nrwiersma/hardware-components/models/C_Pol_Elec_8x10.step

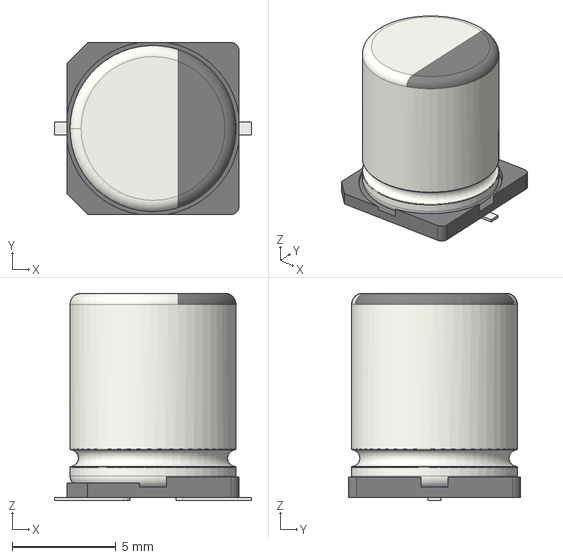
[picture p1: CAD file, 2026-09-28]
models/C_Pol_Elec_8x10.step
9.50 x 8.30 x 10.0 mm
