nrwiersma/hardware-components/models/Conn_Weidmuller_8000078321.step

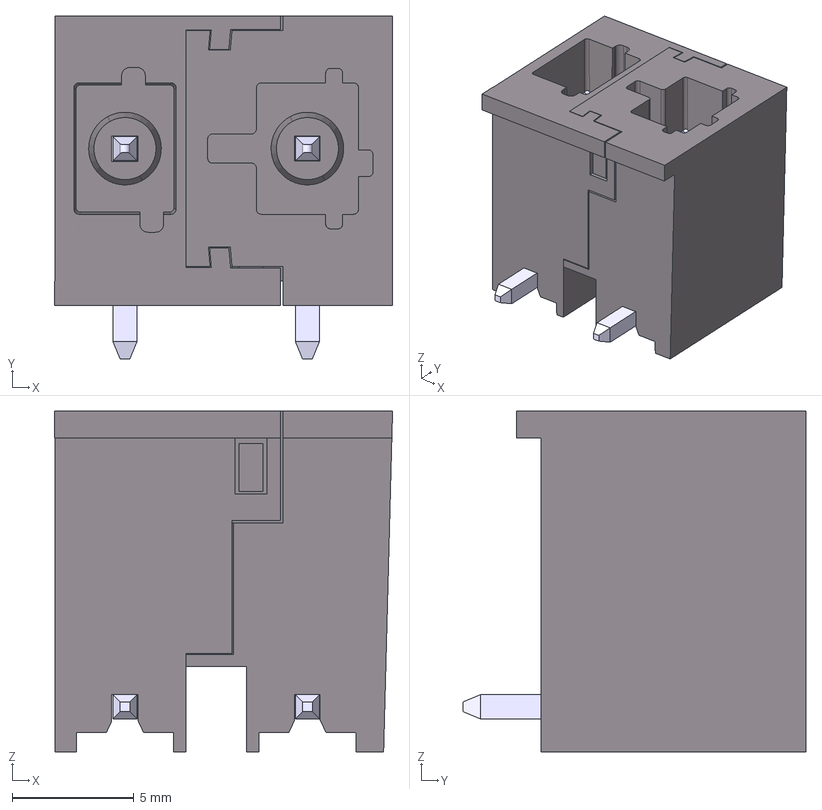
[picture p2: CAD file, 2026-09-28]
models/Conn_Weidmuller_8000078321.step
13.9 x 14.1 x 14.0 mm
X-axis x 3
XY-plane x 3
