nrwiersma/hardware-components/models/Conn_RCA_SameSky_RCJ-041.step

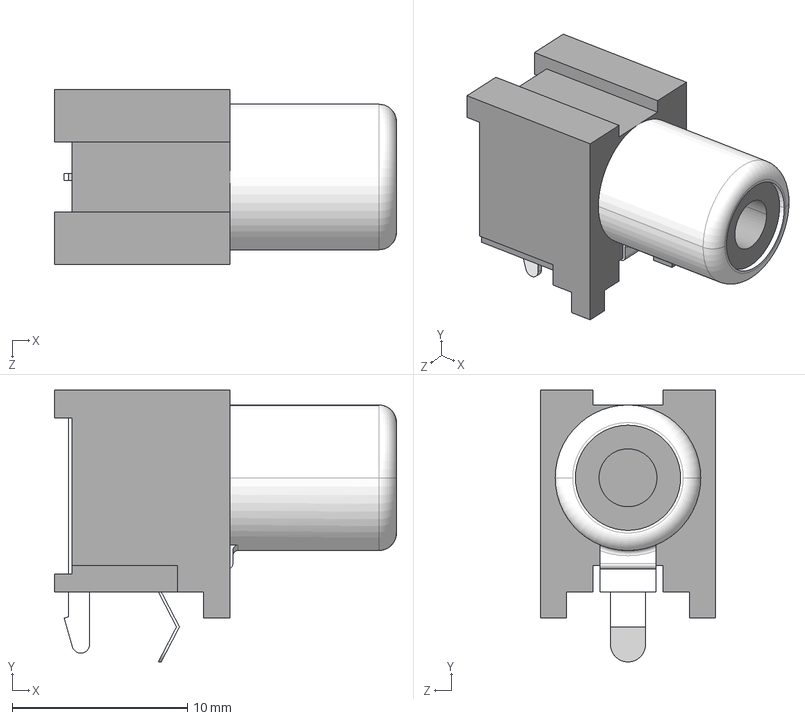
[picture p3: CAD file, 2026-09-28]
models/Conn_RCA_SameSky_RCJ-041.step
19.5 x 15.5 x 10.0 mm
