nrwiersma/hardware-components/models/HTSSOP-28.step

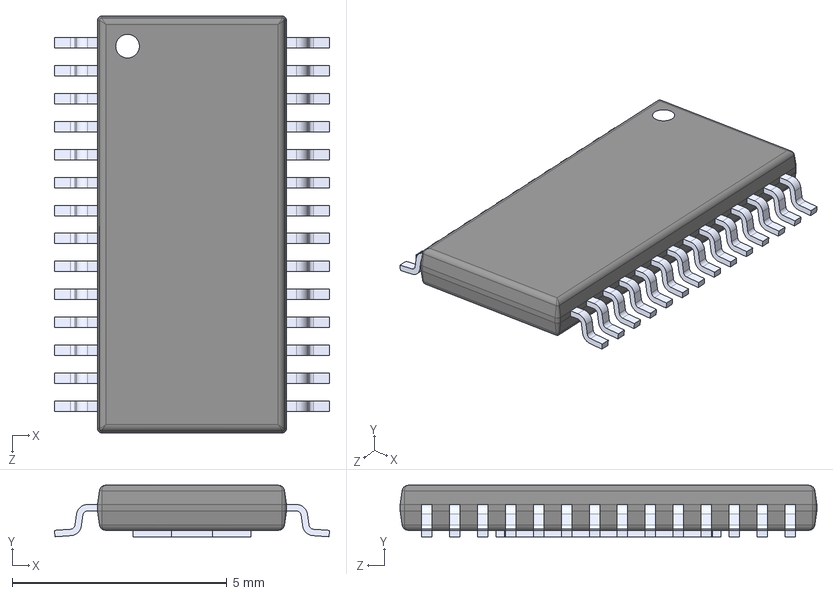
[picture p4: CAD file, 2026-09-28]
models/HTSSOP-28.step
6.40 x 1.20 x 9.70 mm
