nrwiersma/hardware-components/models/L_Sunltech_SLD10D40S100MTT.step

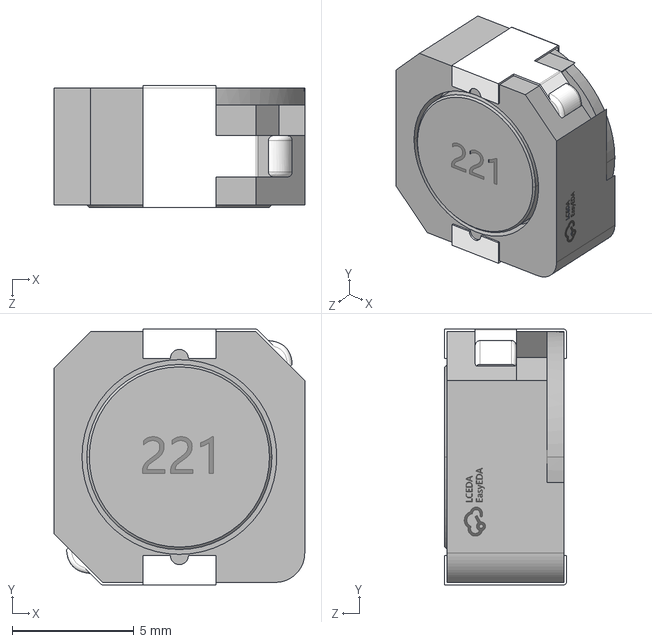
[picture p5: CAD file, 2026-09-28]
models/L_Sunltech_SLD10D40S100MTT.step
10.3 x 10.5 x 5.00 mm
