nrwiersma/hardware-components/models/Conn_BarrelJack_KHE_DC-044A-20A.step

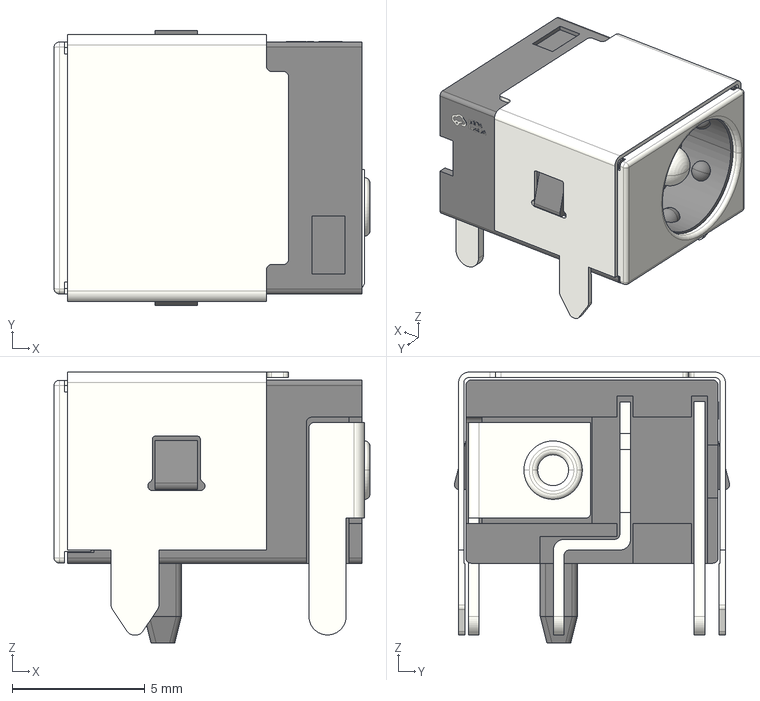
[picture p6: CAD file, 2026-09-28]
models/Conn_BarrelJack_KHE_DC-044A-20A.step
11.9 x 10.4 x 10.2 mm
