nrwiersma/hardware-components/models/PowMan_TPS2121RUXR.step

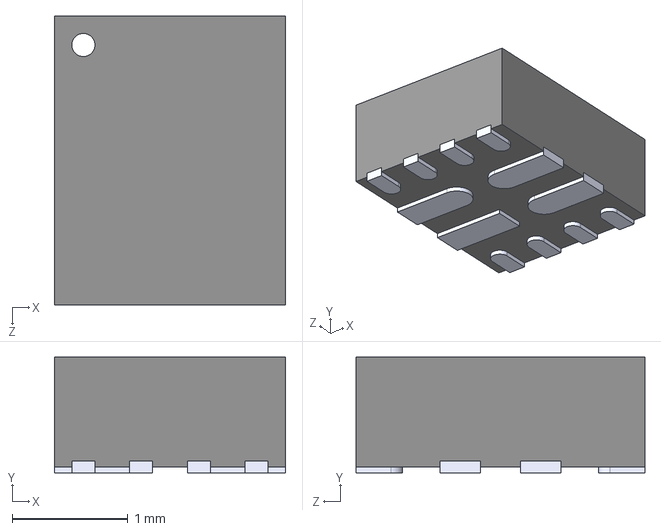
[picture p7: CAD file, 2026-09-28]
models/PowMan_TPS2121RUXR.step
2.00 x 1.00 x 2.50 mm
