nrwiersma/hardware-components/models/SOIC-8_5.3x5.3mm_P1.27mm.step

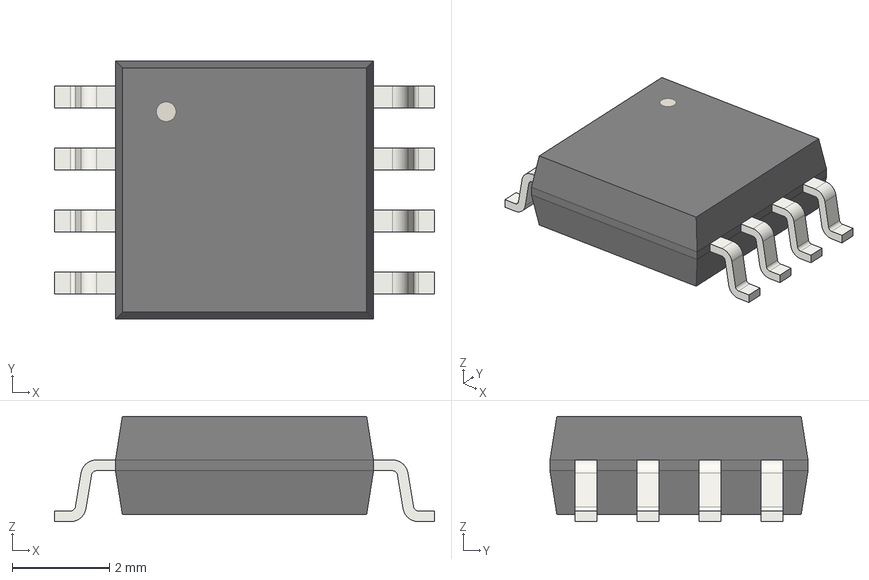
[picture p8: CAD file, 2026-09-28]
models/SOIC-8_5.3x5.3mm_P1.27mm.step
7.80 x 5.30 x 2.16 mm
