nrwiersma/hardware-components/models/BH1750FVI-TR.step

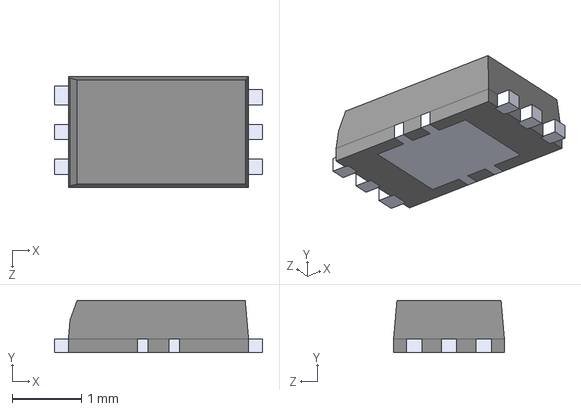
[picture p9: CAD file, 2026-08-22]
models/BH1750FVI-TR.step
3.00 x 0.75 x 1.60 mm
