nrwiersma/hardware-components/models/Sensirion_DFN-4.step

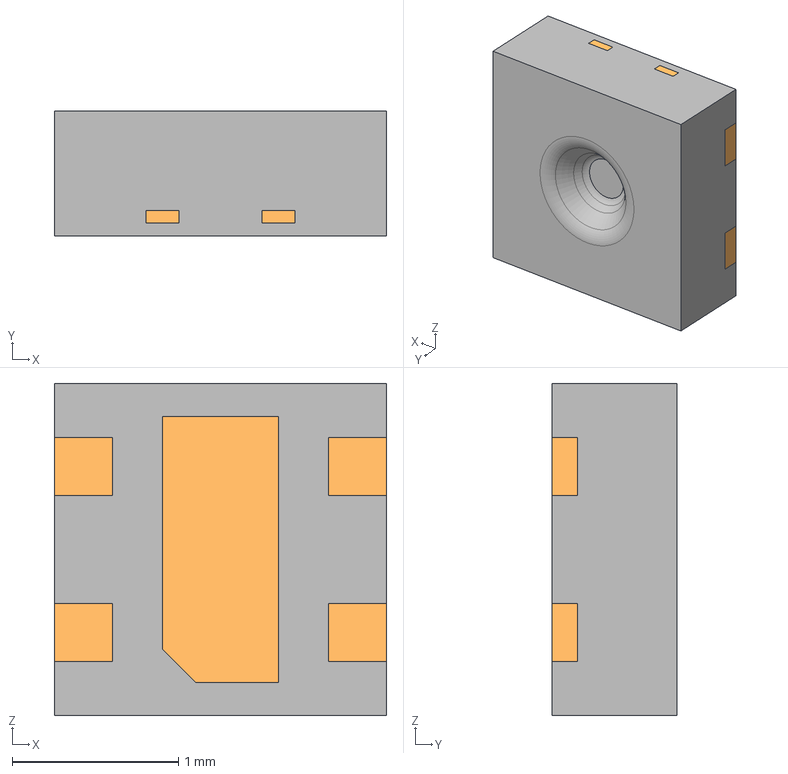
[picture p10: CAD file, 2026-08-22]
models/Sensirion_DFN-4.step
2.00 x 0.75 x 2.00 mm
