nrwiersma/hardware-components/models/LED_WS2812C-2020.step

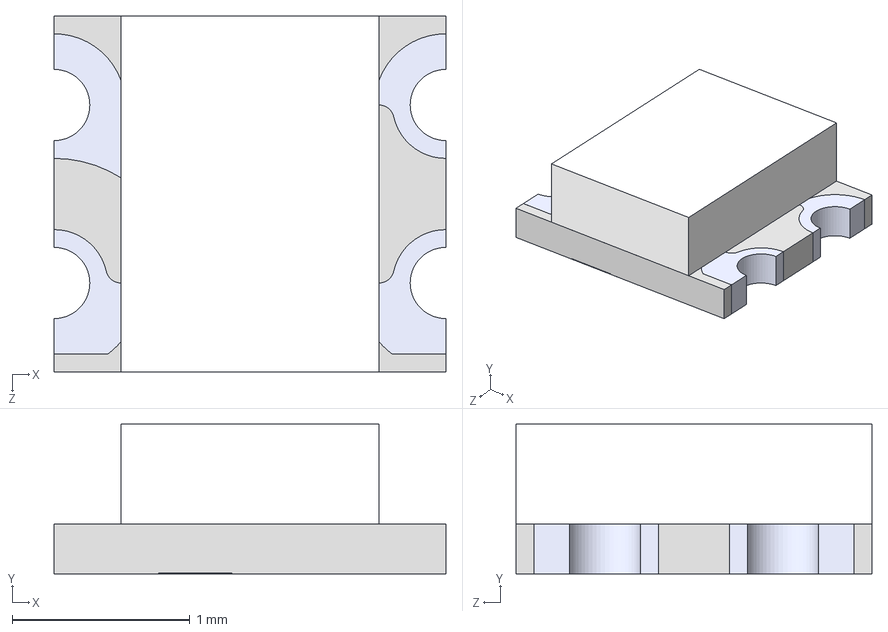
[picture p11: CAD file, 2026-08-22]
models/LED_WS2812C-2020.step
2.20 x 0.84 x 2.00 mm
