nrwiersma/hardware-components/models/HLK-LD2450.step

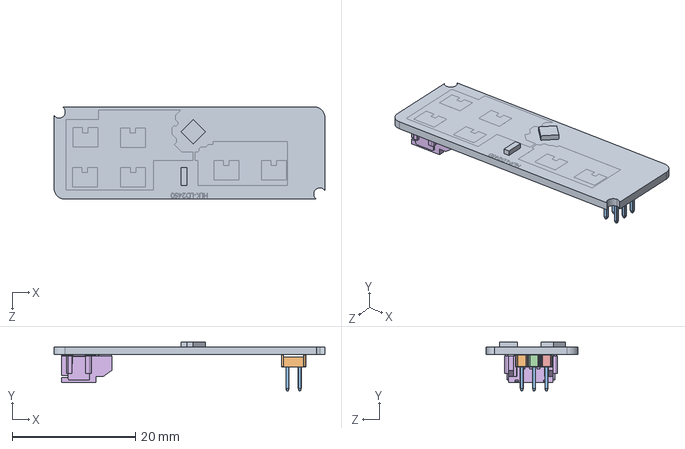
[picture p12: CAD file, 2026-08-22]
models/HLK-LD2450.step
44.0 x 7.95 x 15.0 mm
