nrwiersma/hardware-components/models/PowMan_TPS2116DRLR.step

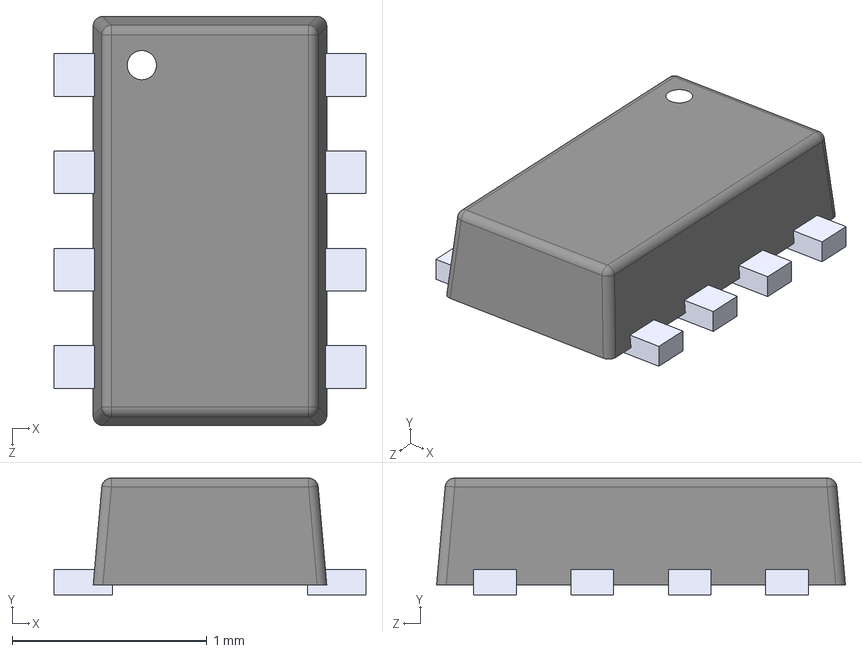
[picture p13: CAD file, 2026-08-22]
models/PowMan_TPS2116DRLR.step
1.60 x 0.6 x 2.10 mm
