nrwiersma/hardware-components/models/Conn_PinSocket_2x04_P2mm_Vertical_SMD.step

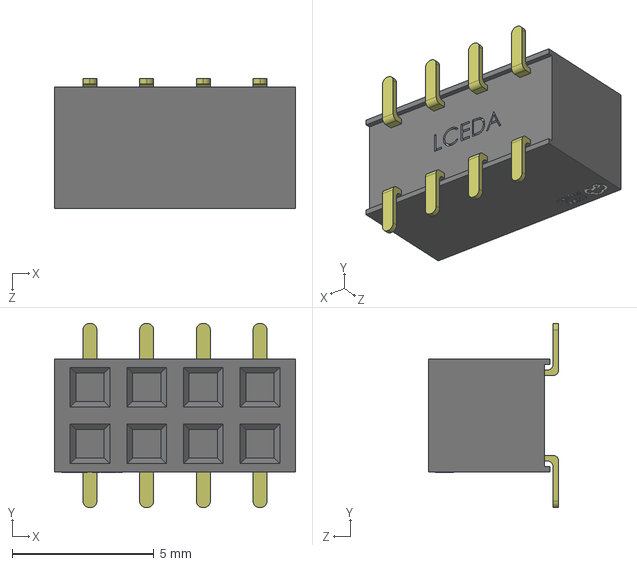
[picture p14: CAD file, 2026-08-22]
models/Conn_PinSocket_2x04_P2mm_Vertical_SMD.step
8.50 x 6.50 x 4.60 mm
