nrwiersma/hardware-components/models/D_SOD-323.step

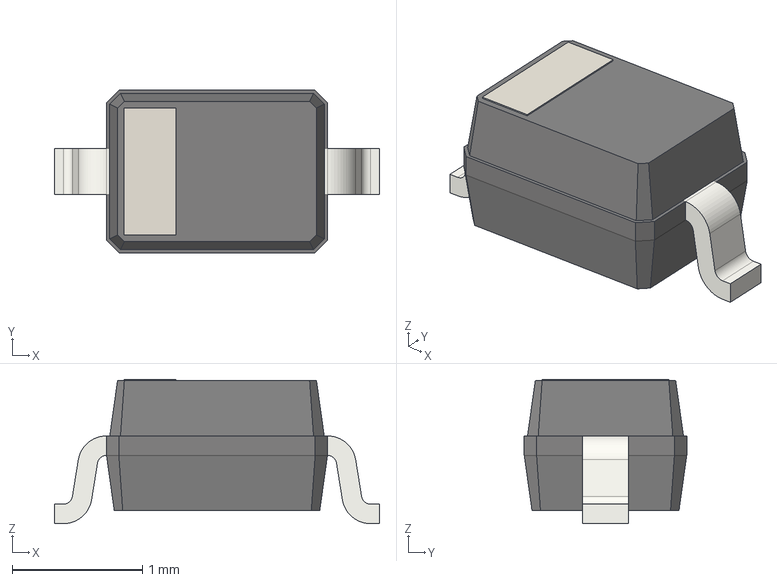
[picture p15: CAD file, 2026-08-22]
models/D_SOD-323.step
2.50 x 1.25 x 1.11 mm
