nrwiersma/hardware-components/models/Conn_PinSocket_2x04_P2.00mm_Vertical.step

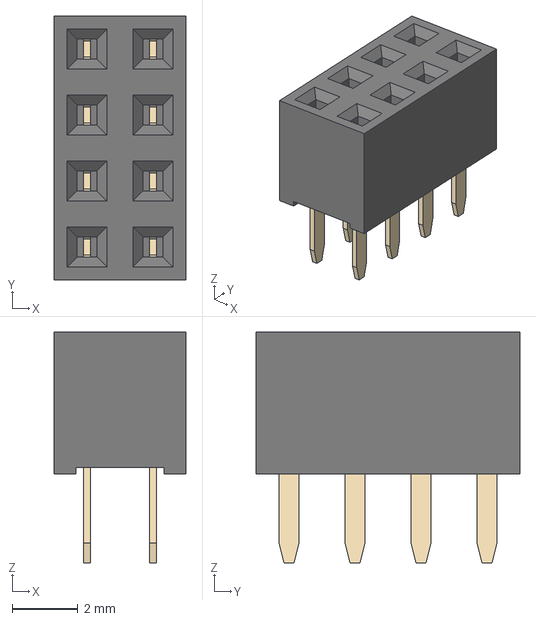
[picture p16: CAD file, 2026-08-22]
models/Conn_PinSocket_2x04_P2.00mm_Vertical.step
4.00 x 8.00 x 7.00 mm
