nrwiersma/hardware-components/models/C_0402_1005Metric.step

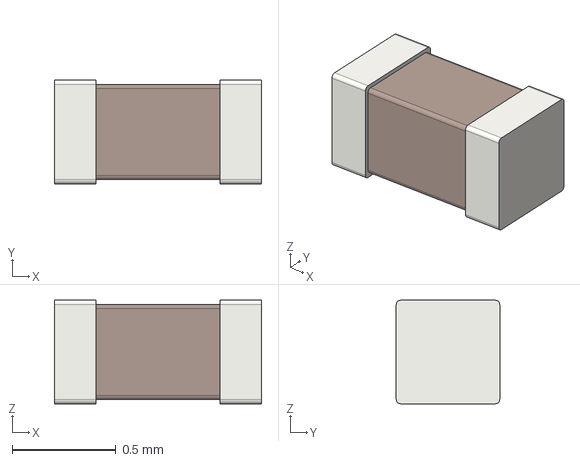
[picture p17: CAD file, 2025-12-20]
models/C_0402_1005Metric.step
1.00 x 0.5 x 0.5 mm
