nrwiersma/hardware-components/models/R_0402_1005Metric.step

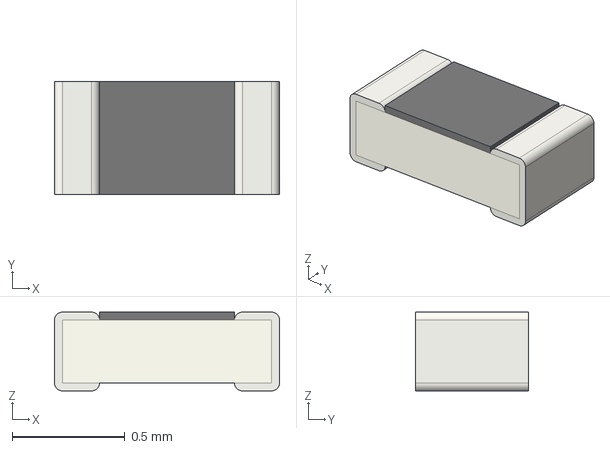
[picture p18: CAD file, 2025-12-20]
models/R_0402_1005Metric.step
1.00 x 0.5 x 0.35 mm
