nrwiersma/hardware-components/models/L_Chilisin_BMRx00060630.step

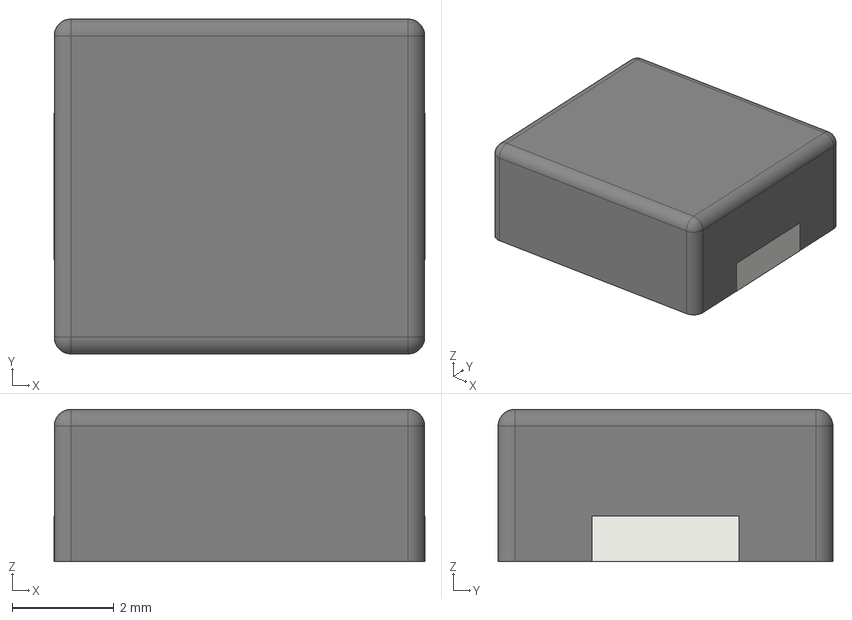
[picture p19: CAD file, 2025-12-20]
models/L_Chilisin_BMRx00060630.step
7.31 x 6.60 x 3.00 mm
b9f41f3a-8551-11ed-b402-00155d22e2d7_part
b9f42070-8551-11ed-b402-00155d22e2d7_part
b9f420f2-8551-11ed-b402-00155d22e2d7_part
