nrwiersma/hardware-components/models/TPD4EUSB30_USON-10.step

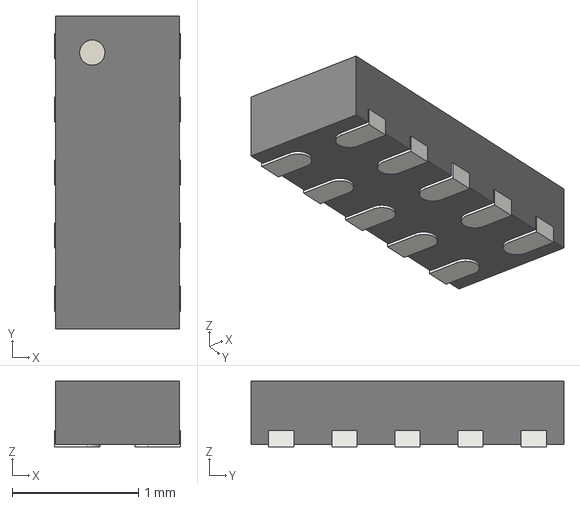
[picture p20: CAD file, 2025-12-20]
models/TPD4EUSB30_USON-10.step
1.00 x 2.48 x 0.52 mm
