nrwiersma/hardware-components/models/LED_0603_1608Metric.step

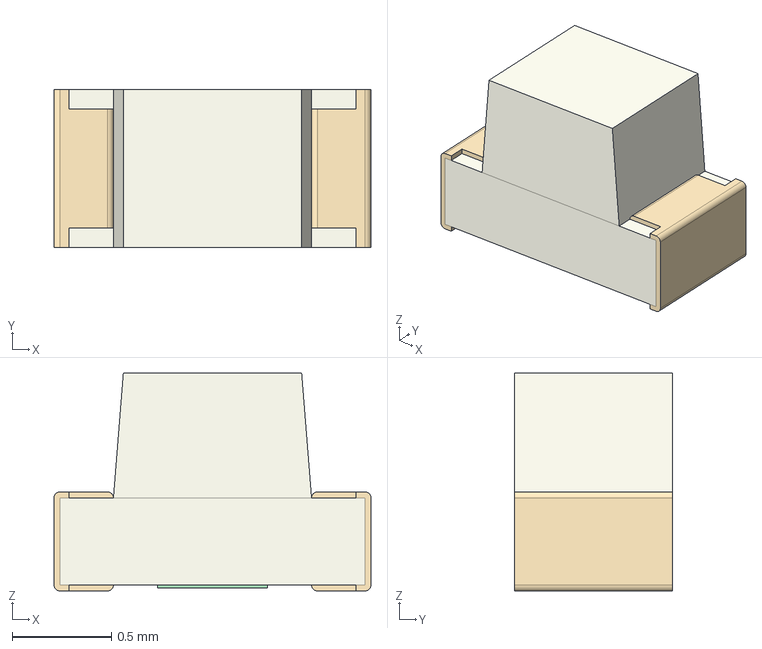
[picture p21: CAD file, 2025-12-20]
models/LED_0603_1608Metric.step
1.60 x 0.8 x 1.10 mm
