nrwiersma/hardware-components/models/Conn_JST_PH_S4B-PH-K_1x04_P2.00mm_Horizontal.step

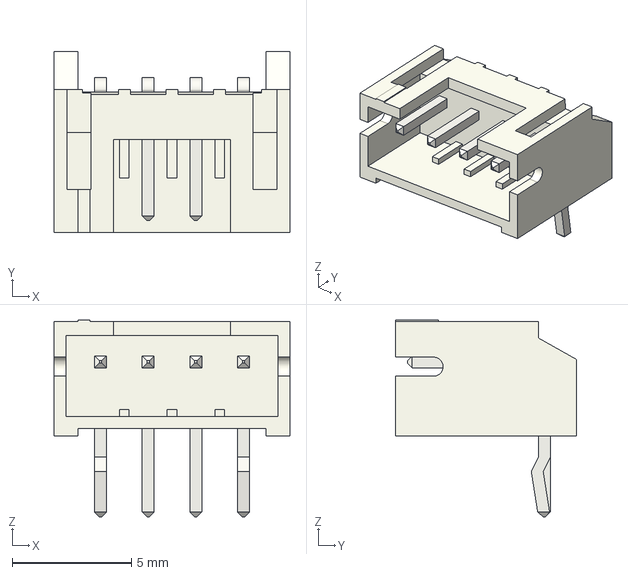
[picture p22: CAD file, 2025-12-20]
models/Conn_JST_PH_S4B-PH-K_1x04_P2.00mm_Horizontal.step
9.90 x 7.60 x 8.25 mm
