nrwiersma/hardware-components/models/SSR_SUPSiC_GAQY212GSX.step

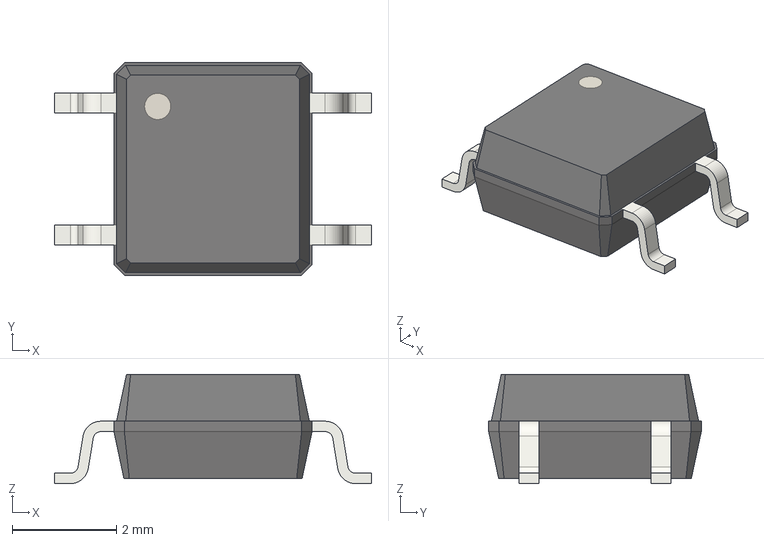
[picture p23: CAD file, 2025-12-20]
models/SSR_SUPSiC_GAQY212GSX.step
6.10 x 4.09 x 2.10 mm
