nrwiersma/hardware-components/models/QFN-32-1EP.step

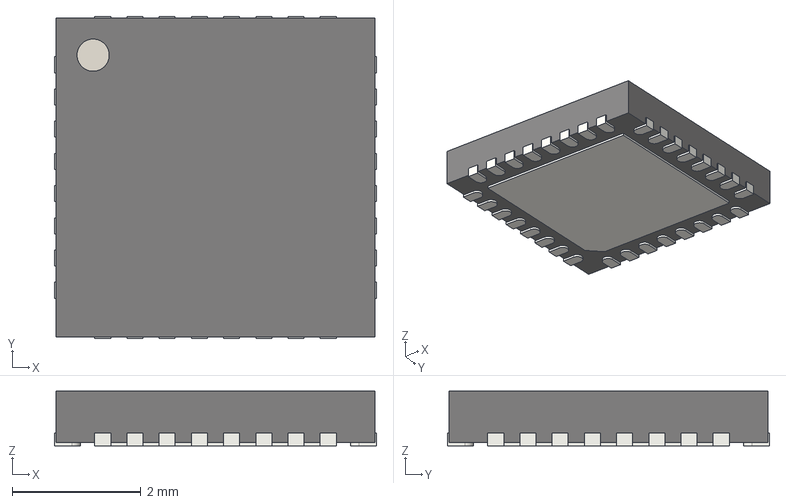
[picture p24: CAD file, 2025-12-20]
models/QFN-32-1EP.step
5.00 x 5.00 x 0.85 mm
