nrwiersma/hardware-components/models/Conn_JST_PH_S3B-PH-K_1x03_P2.00mm_Horizontal.step

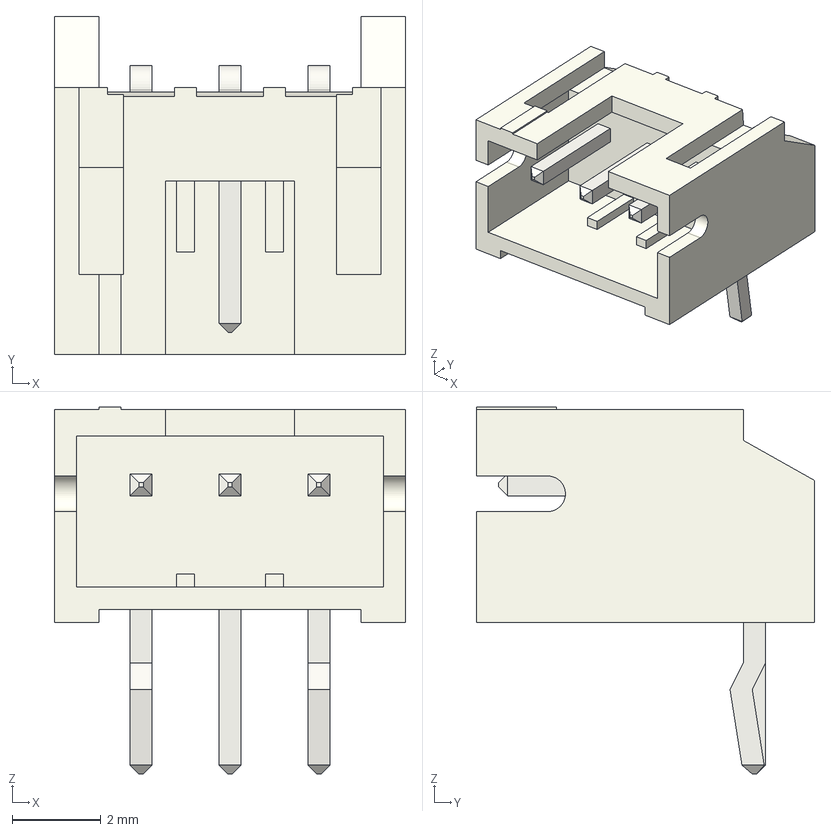
[picture p25: CAD file, 2025-12-20]
models/Conn_JST_PH_S3B-PH-K_1x03_P2.00mm_Horizontal.step
7.90 x 7.60 x 8.25 mm
