nrwiersma/hardware-components/models/C_0201_0603Metric.step

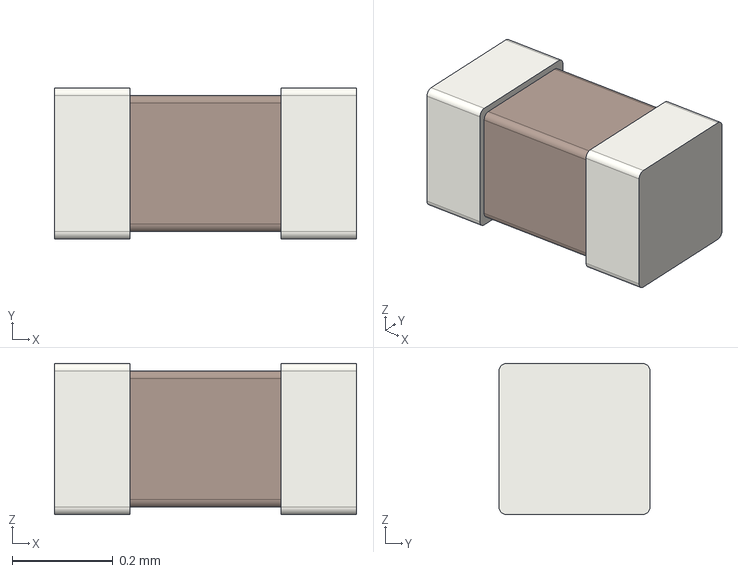
[picture p26: CAD file, 2025-12-20]
models/C_0201_0603Metric.step
0.6 x 0.3 x 0.3 mm
