nrwiersma/hardware-components/models/SMD-FERRITE-BEAD-30R-3A_0805_.step

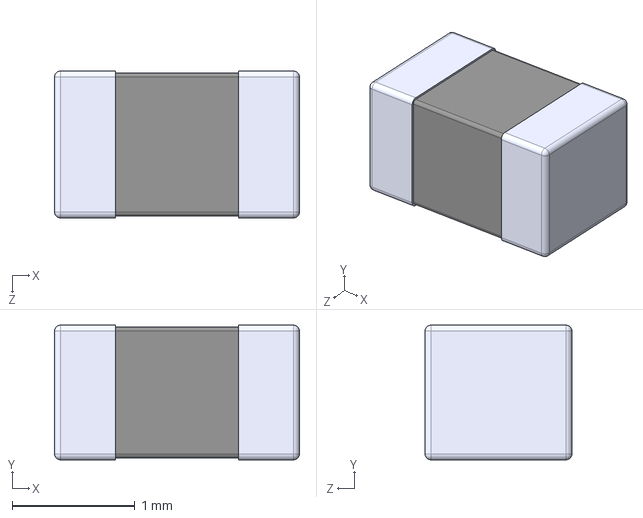
[picture p27: CAD file, 2025-12-20]
models/SMD-FERRITE-BEAD-30R-3A_0805_.step
2.00 x 1.10 x 1.20 mm
