nrwiersma/hardware-components/models/Conn_PinHeader_2x05_P2.54mm_Vertical.step

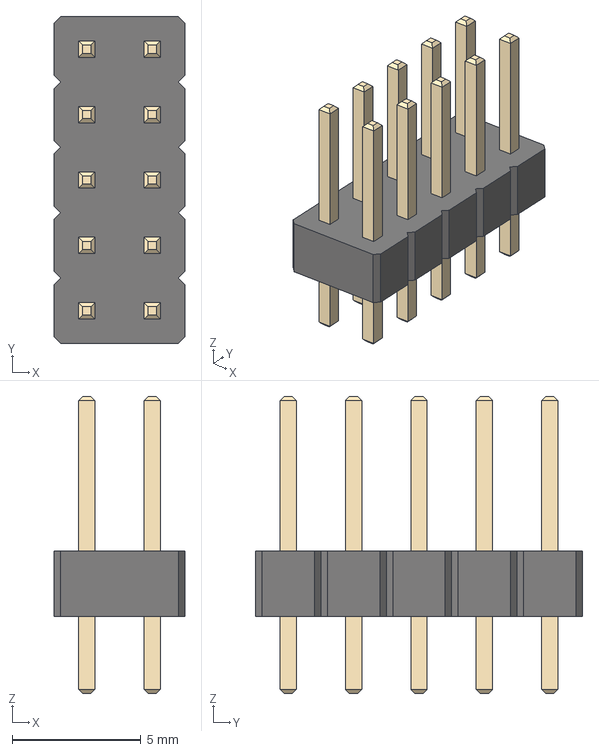
[picture p28: CAD file, 2025-12-20]
models/Conn_PinHeader_2x05_P2.54mm_Vertical.step
5.08 x 12.7 x 11.5 mm
