nrwiersma/hardware-components/models/D_0402_1005Metric.STEP

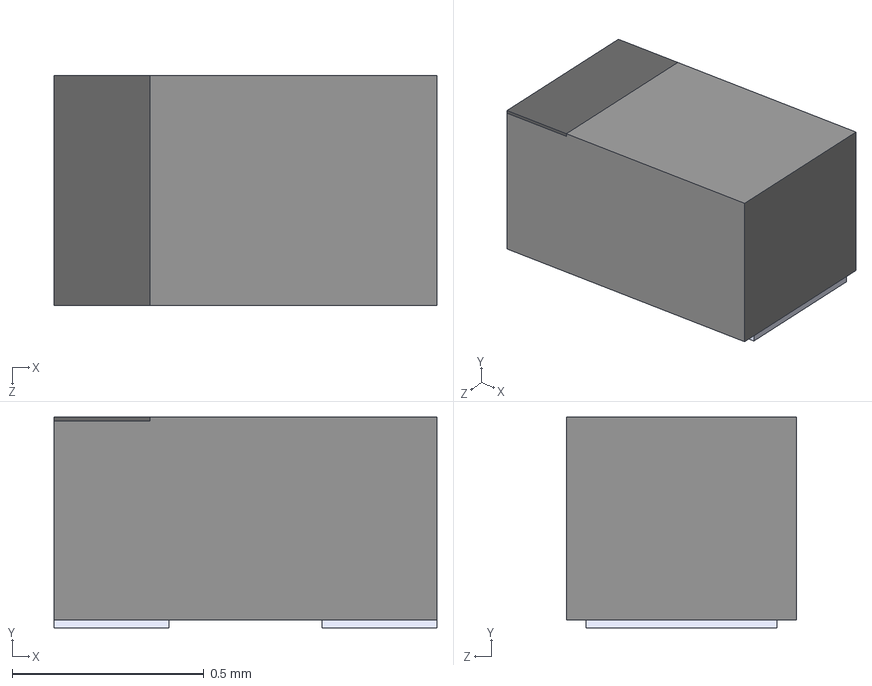
[picture p29: CAD file, 2025-12-20]
models/D_0402_1005Metric.STEP
1.00 x 0.55 x 0.6 mm
