nrwiersma/hardware-components/models/SOT-89-3.step

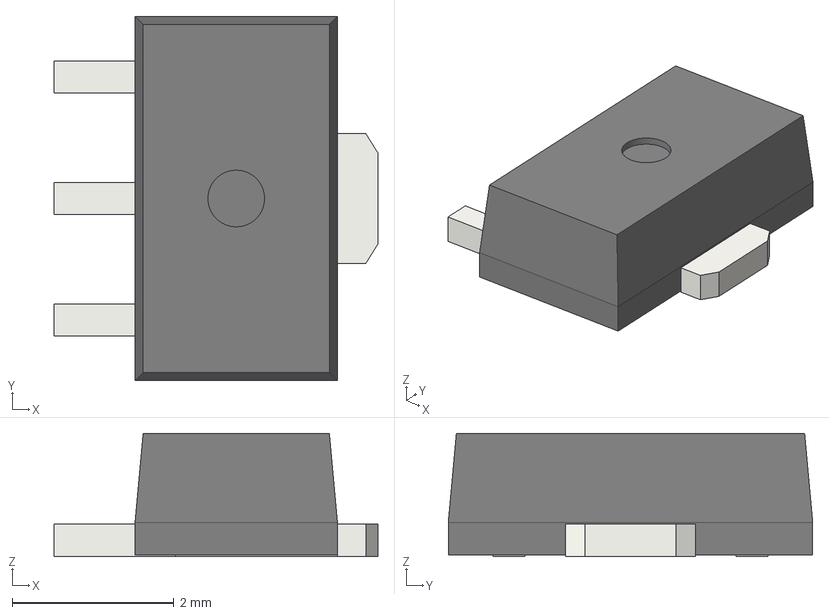
[picture p30: CAD file, 2025-12-20]
models/SOT-89-3.step
4.00 x 4.50 x 1.52 mm
adbeea57-9c39-11ed-93f0-dde97e994e83_part
adbeea58-9c39-11ed-93f0-dde97e994e83_part
adbeea59-9c39-11ed-93f0-dde97e994e83_part
