nrwiersma/hardware-components/models/C_0603_1608Metric.step

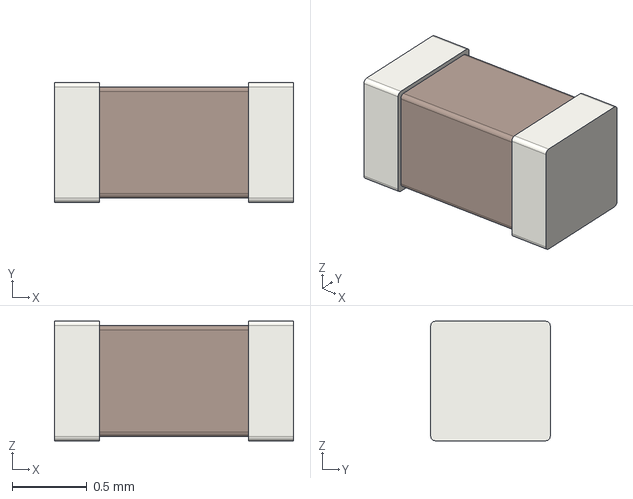
[picture p31: CAD file, 2025-12-20]
models/C_0603_1608Metric.step
1.60 x 0.8 x 0.8 mm
