nrwiersma/hardware-components/models/Conn_PinHeader_2x04_P2.54mm_Vertical.step

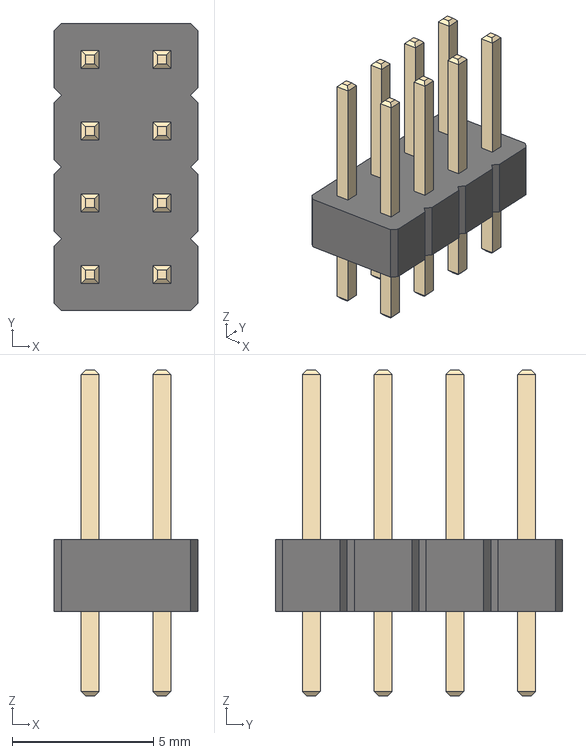
[picture p32: CAD file, 2025-12-20]
models/Conn_PinHeader_2x04_P2.54mm_Vertical.step
5.08 x 10.2 x 11.5 mm
