nrwiersma/hardware-components/models/R_0201_0603Metric.step

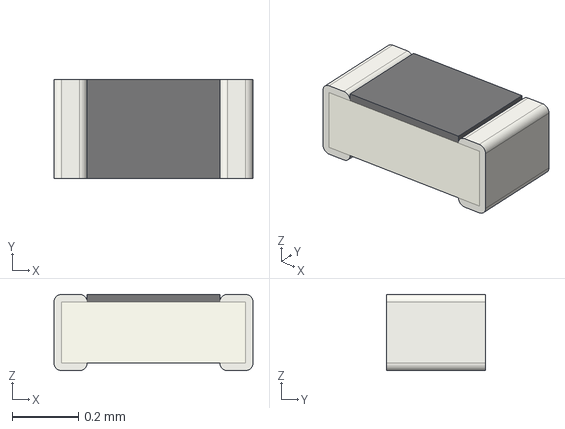
[picture p33: CAD file, 2025-12-20]
models/R_0201_0603Metric.step
0.6 x 0.3 x 0.23 mm
