nrwiersma/hardware-components/models/Raspberry-Pi_CM4.step

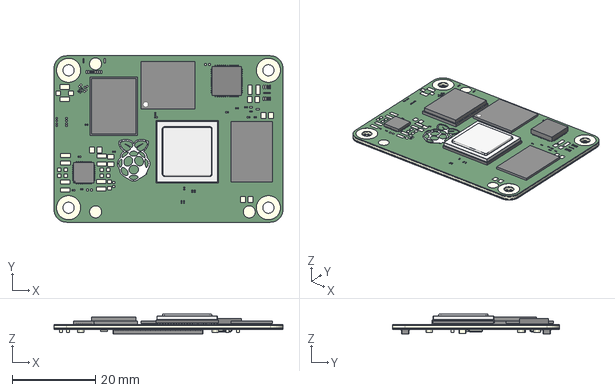
[picture p34: CAD file, 2025-12-20]
models/Raspberry-Pi_CM4.step
55.0 x 40.0 x 4.78 mm
