nrwiersma/hardware-components/models/L_0805_2012Metric.step

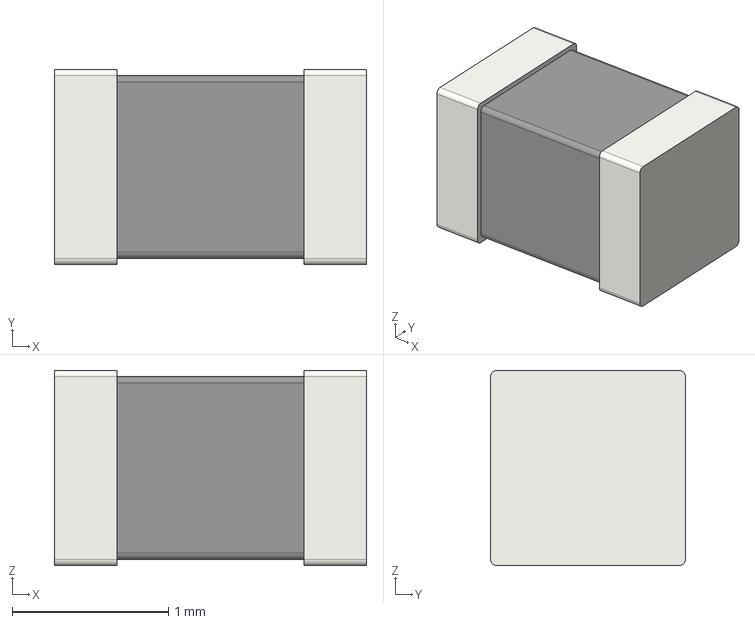
[picture p35: CAD file, 2025-12-20]
models/L_0805_2012Metric.step
2.00 x 1.25 x 1.25 mm
