nrwiersma/hardware-components/models/WSON-6-1EP_2x2mm_P0.65mm_EP1x1.6mm_ThermalVias.step

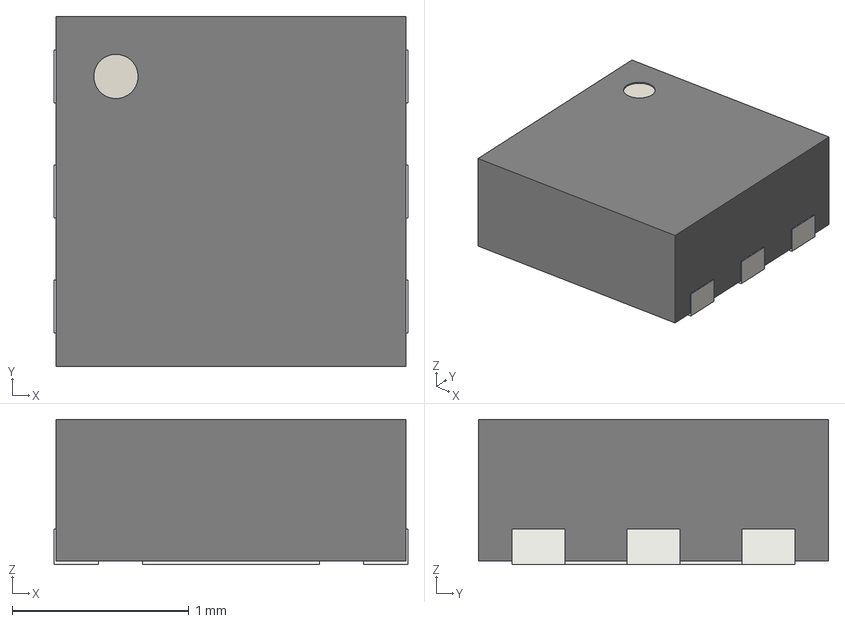
[picture p36: CAD file, 2025-12-20]
models/WSON-6-1EP_2x2mm_P0.65mm_EP1x1.6mm_ThermalVias.step
2.00 x 1.98 x 0.82 mm
