nrwiersma/hardware-components/models/SW_Panasonic_EVQPUC.step

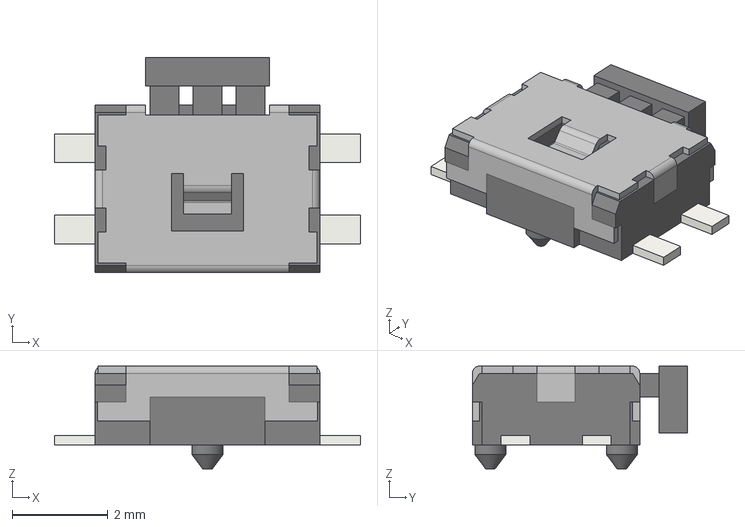
[picture p38: CAD file, 2025-12-20]
models/SW_Panasonic_EVQPUC.step
6.40 x 4.50 x 2.15 mm
