nrwiersma/hardware-components/models/SOT-353_SC-70-5.step

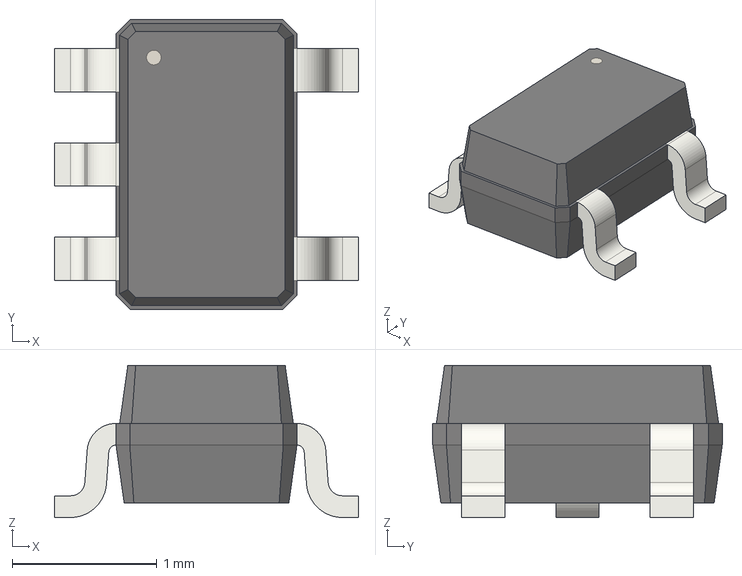
[picture p39: CAD file, 2025-12-20]
models/SOT-353_SC-70-5.step
2.10 x 2.00 x 1.05 mm
