nrwiersma/hardware-components/models/SOT-23-6.step

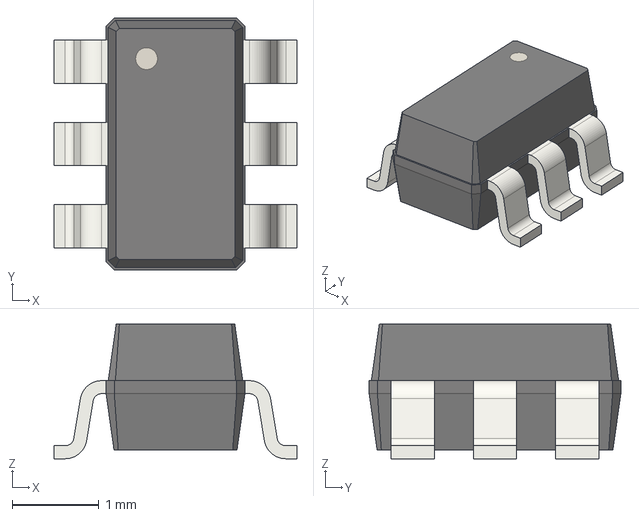
[picture p40: CAD file, 2025-12-20]
models/SOT-23-6.step
2.80 x 2.90 x 1.55 mm
