nrwiersma/hardware-components/models/RT9742GGJ5_SOT-23-5.step

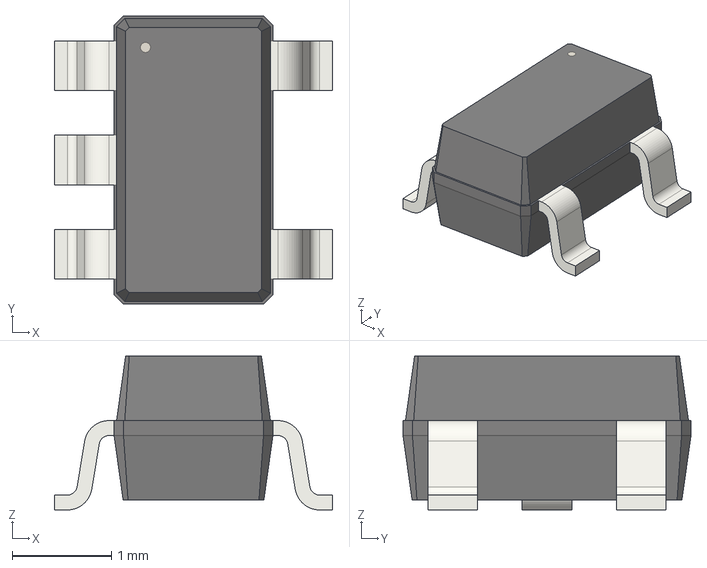
[picture p41: CAD file, 2025-12-20]
models/RT9742GGJ5_SOT-23-5.step
2.80 x 2.90 x 1.55 mm
