nrwiersma/hardware-components/models/LQFP-48_7x7mm_P0.5mm.step

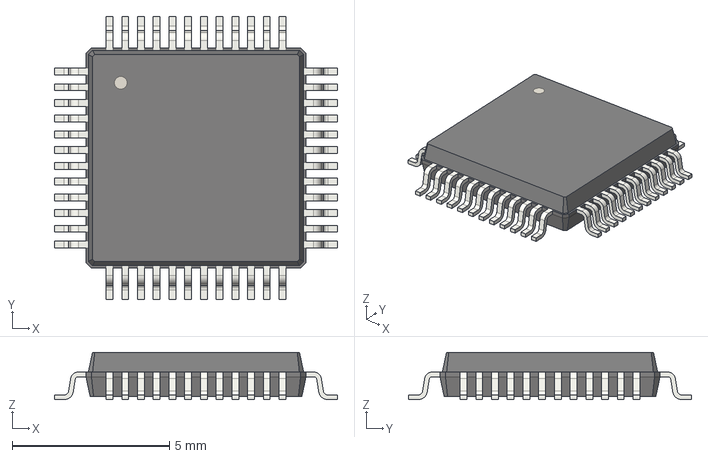
[picture p42: CAD file, 2025-12-20]
models/LQFP-48_7x7mm_P0.5mm.step
9.00 x 9.00 x 1.50 mm
