nrwiersma/hardware-components/models/Fuse_1206_3216Metric.step

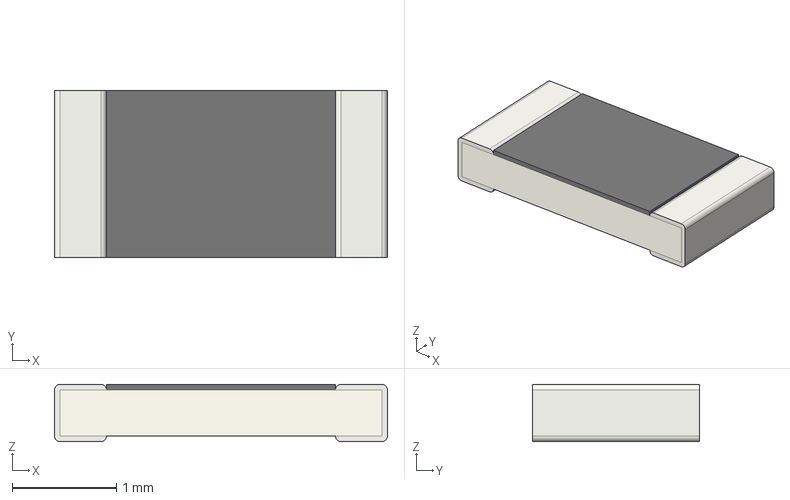
[picture p43: CAD file, 2025-12-20]
models/Fuse_1206_3216Metric.step
3.20 x 1.60 x 0.55 mm
