nrwiersma/hardware-components/models/SW_Panasonic_EVPAA.STEP

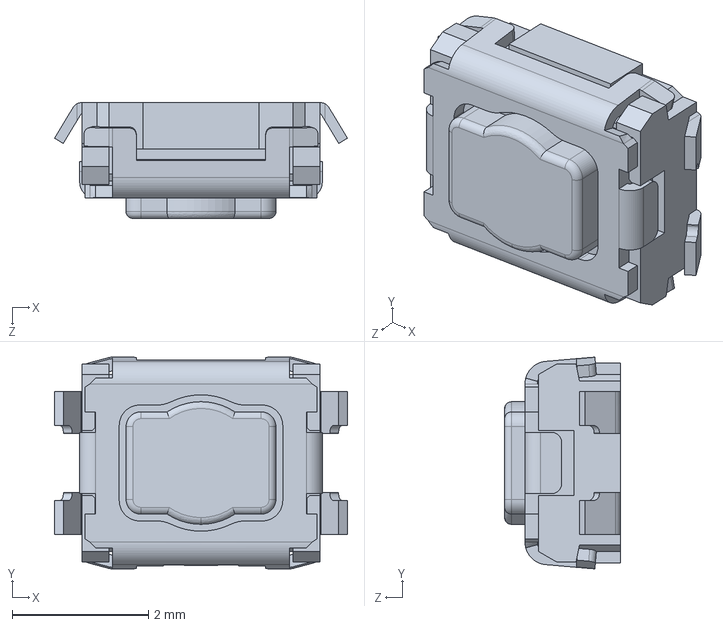
[picture p44: CAD file, 2025-12-20]
models/SW_Panasonic_EVPAA.STEP
4.30 x 3.11 x 1.70 mm
