nrwiersma/hardware-components/models/PTS815SJM250SMTRLFS.stp

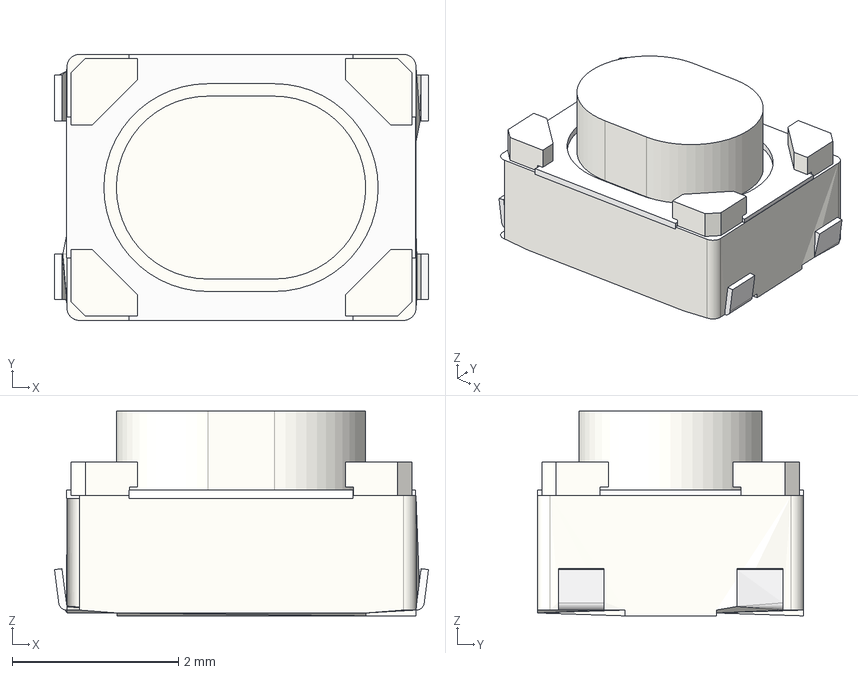
[picture p45: CAD file, 2025-12-01]
models/PTS815SJM250SMTRLFS.stp
4.50 x 3.20 x 2.46 mm
PTS815SJM250SMTRLFS_PART1
PTS815SJM250SMTRLFS_PART2
PTS815SJM250SMTRLFS_PART3
