nrwiersma/hardware-components/models/SW_KSC241JLFS.stp

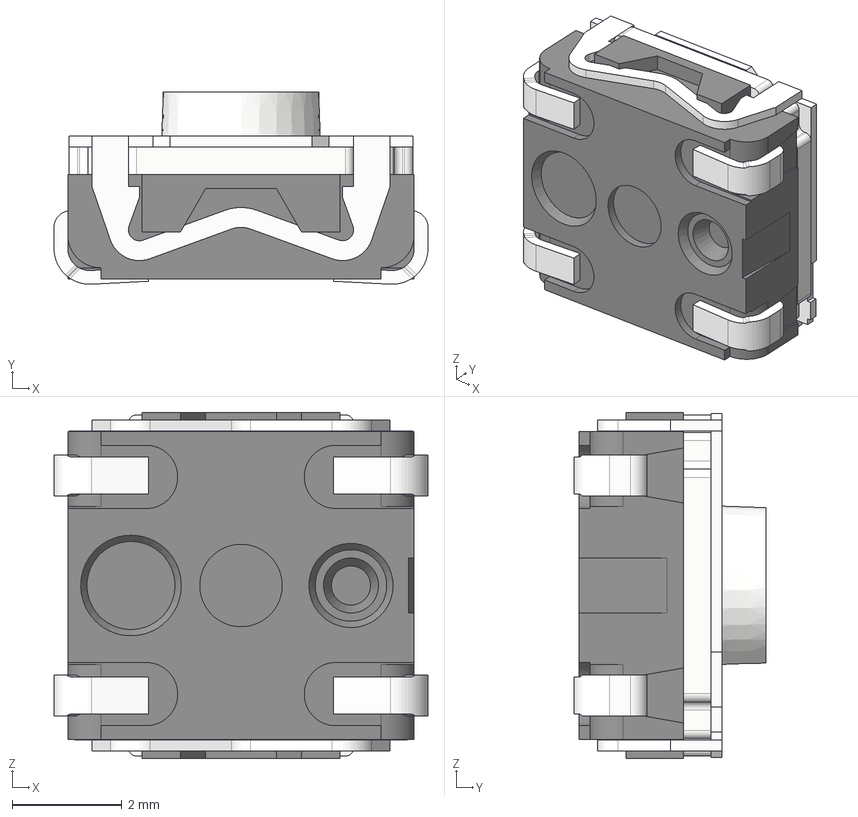
[picture p46: CAD file, 2025-12-01]
models/SW_KSC241JLFS.stp
6.80 x 3.50 x 6.30 mm
KSC2 - body
KSC2 - button
KSC2 - cover
KSC21J_pin x 4
