nrwiersma/hardware-components/models/LED_LTST-C295KGKRKT.STEP

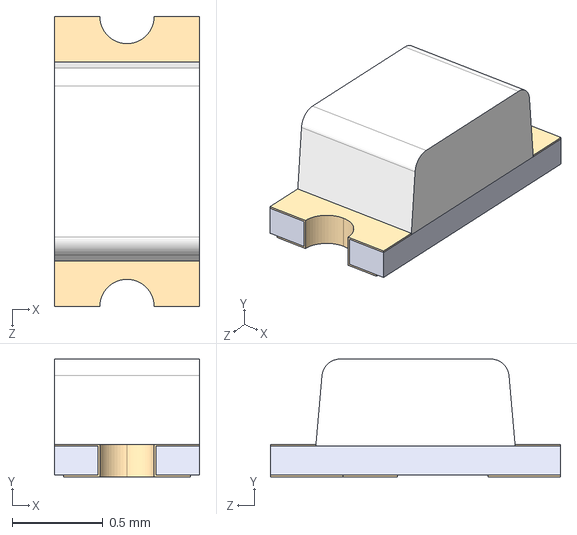
[picture p47: CAD file, 2025-11-22]
models/LED_LTST-C295KGKRKT.STEP
0.8 x 0.65 x 1.60 mm
