nrwiersma/hardware-components/models/Oscillator_ECS_400-10-37B2-CKM-TR.step

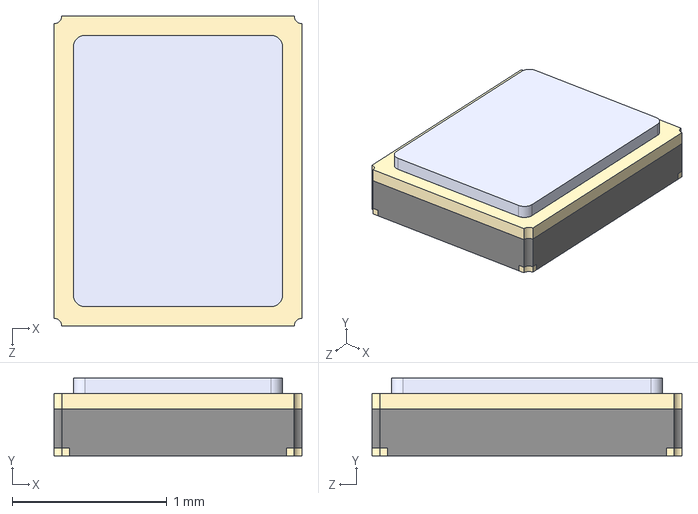
[picture p48: CAD file, 2025-11-22]
models/Oscillator_ECS_400-10-37B2-CKM-TR.step
1.60 x 0.5 x 2.00 mm
