nrwiersma/hardware-components/models/LED_SK6812MINI.stp

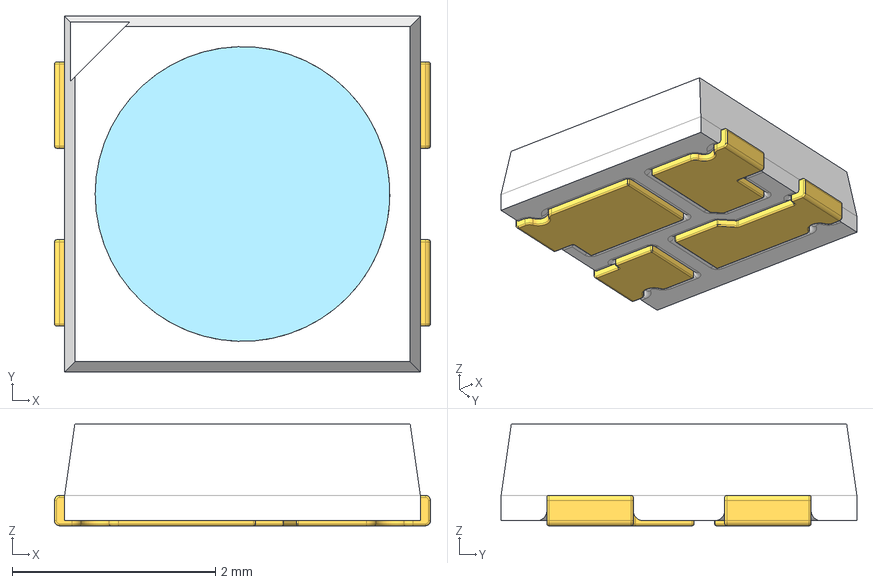
[picture p49: CAD file, 2025-11-17]
models/LED_SK6812MINI.stp
3.70 x 3.50 x 1.00 mm
