nrwiersma/hardware-components/models/TE_640455-4.step

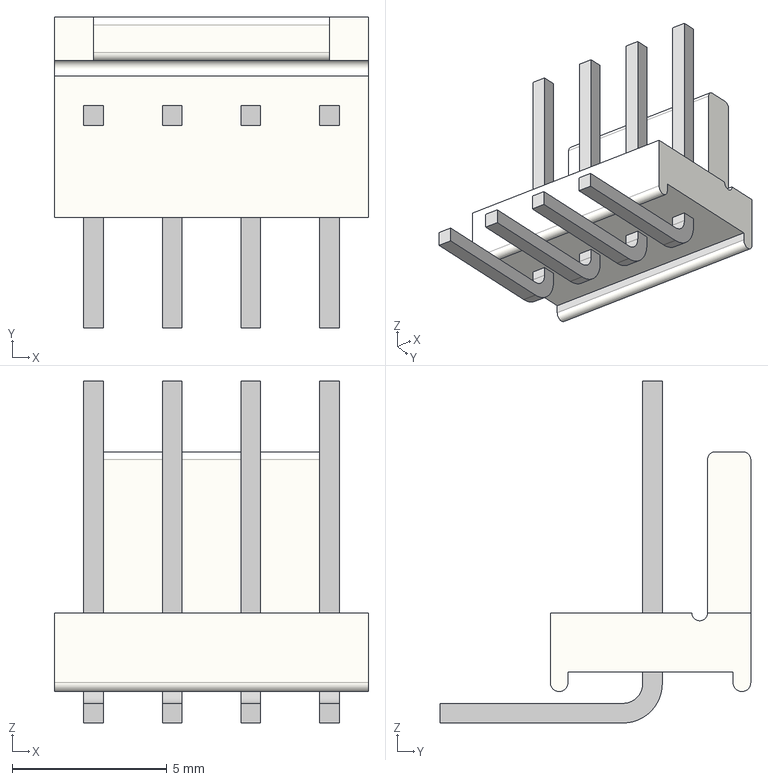
[picture p50: CAD file, 2025-11-17]
models/TE_640455-4.step
10.2 x 10.0 x 11.0 mm
