nrwiersma/hardware-components/models/Bus_M.2_Socket_M.stp

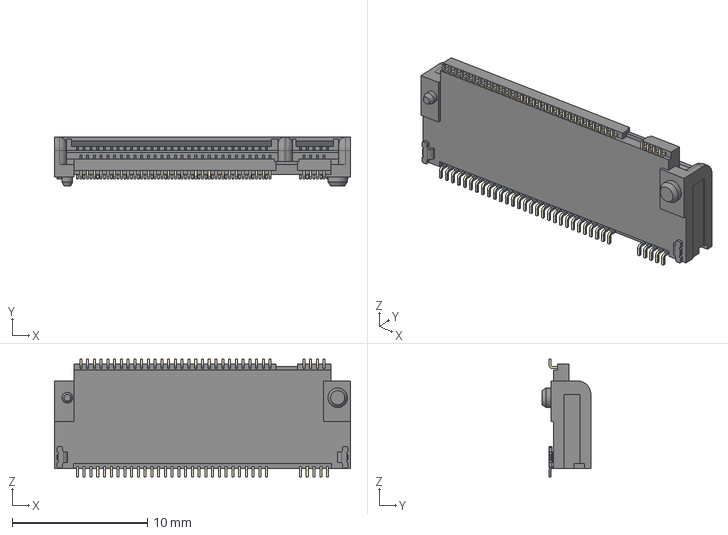
[picture p51: CAD file, 2025-11-17]
models/Bus_M.2_Socket_M.stp
21.9 x 3.62 x 8.70 mm
