nrwiersma/hardware-components/models/Molex_47659-1100.stp

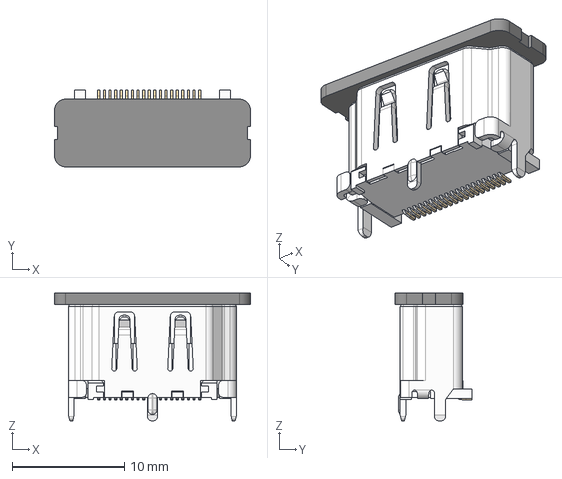
[picture p52: CAD file, 2025-11-17]
models/Molex_47659-1100.stp
17.5 x 6.85 x 11.4 mm
