nrwiersma/hardware-components/models/MOLEX_104031-0811.stp

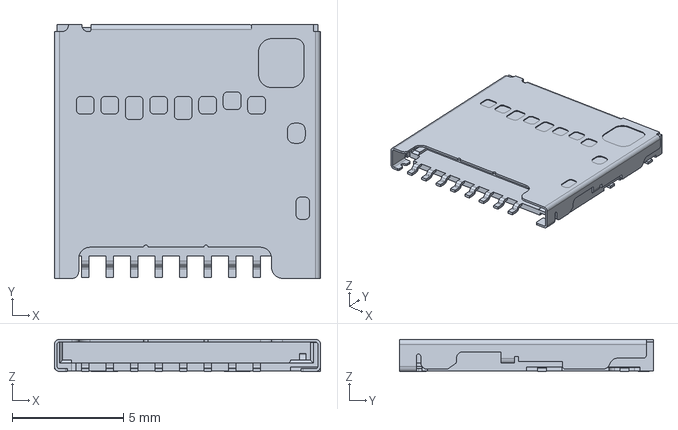
[picture p53: CAD file, 2025-11-11]
models/MOLEX_104031-0811.stp
11.9 x 11.4 x 1.45 mm
