nrwiersma/hardware-components/models/UQFN-32-1.step

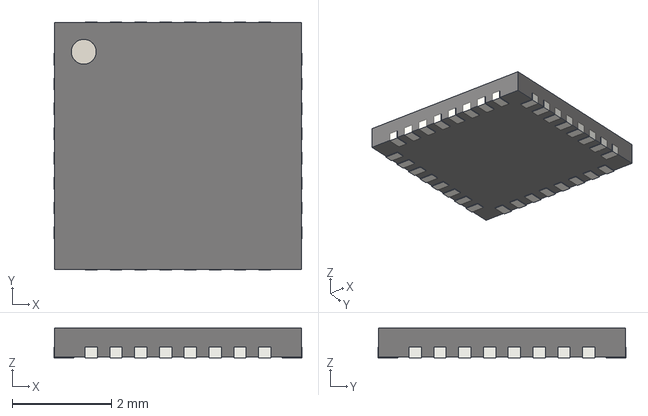
[picture p54: CAD file, 2025-11-11]
models/UQFN-32-1.step
5.00 x 5.00 x 0.6 mm
