nrwiersma/hardware-components/models/PUSB3F96X.STEP

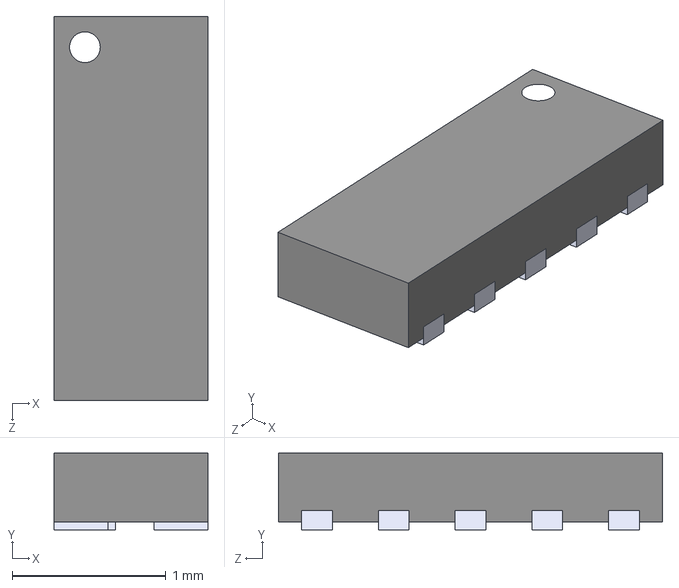
[picture p55: CAD file, 2025-11-11]
models/PUSB3F96X.STEP
1.00 x 0.5 x 2.50 mm
