nrwiersma/hardware-components/models/MSOP8_MC_MCH.step

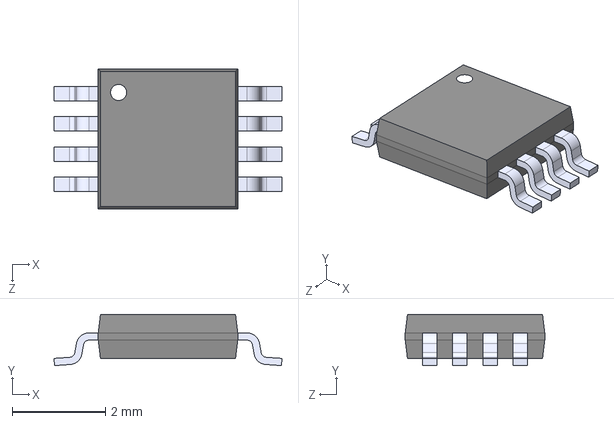
[picture p56: CAD file, 2025-11-11]
models/MSOP8_MC_MCH.step
4.90 x 1.10 x 3.00 mm
