nrwiersma/hardware-components/models/MB110S.STEP

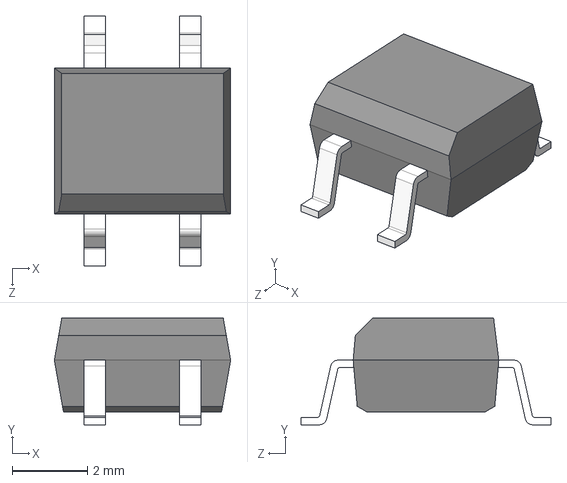
[picture p57: CAD file, 2025-11-08]
models/MB110S.STEP
4.69 x 2.84 x 6.65 mm
