nrwiersma/hardware-components/models/SMAJ58A.step

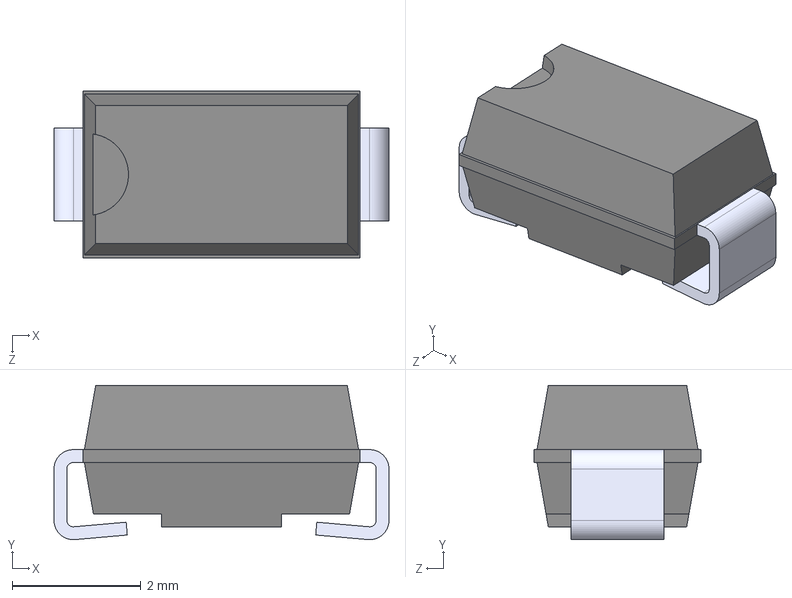
[picture p58: CAD file, 2025-11-08]
models/SMAJ58A.step
5.21 x 2.40 x 2.60 mm
