nrwiersma/hardware-components/models/AG9900LP.step

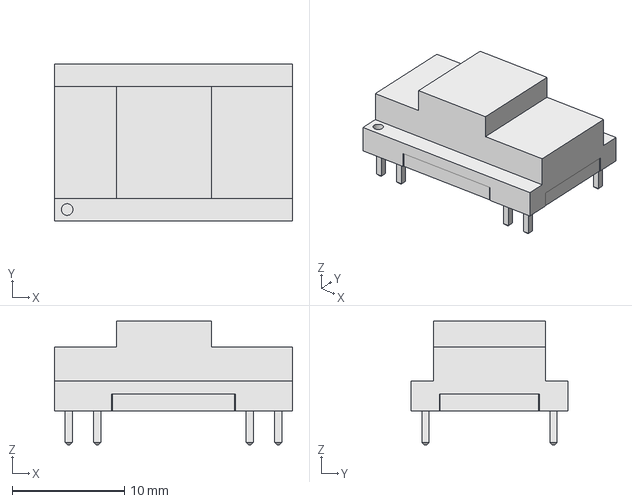
[picture p59: CAD file, 2025-11-08]
models/AG9900LP.step
21.2 x 14.0 x 11.0 mm
