nrwiersma/hardware-components/models/DGUK111Q334AB2A2DP057.stp

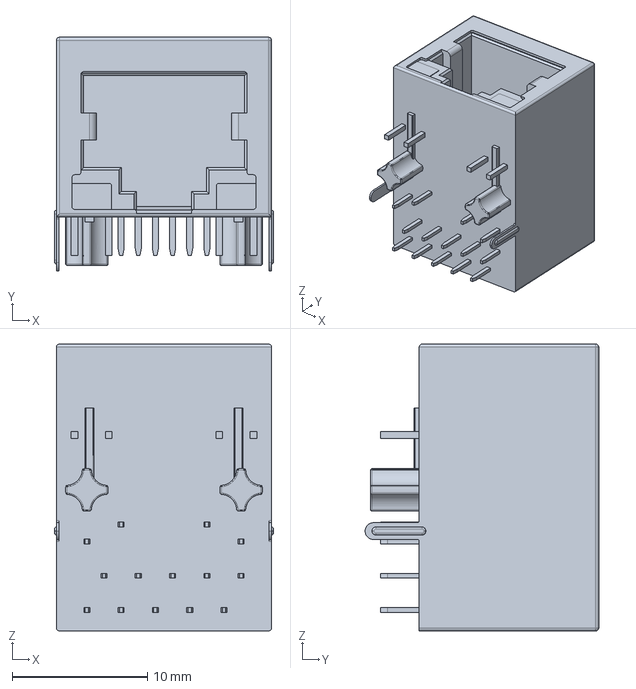
[picture p60: CAD file, 2025-11-08]
models/DGUK111Q334AB2A2DP057.stp
16.2 x 17.3 x 21.2 mm
