nrwiersma/hardware-components/models/CP2102N-A02-GQFN24R.step

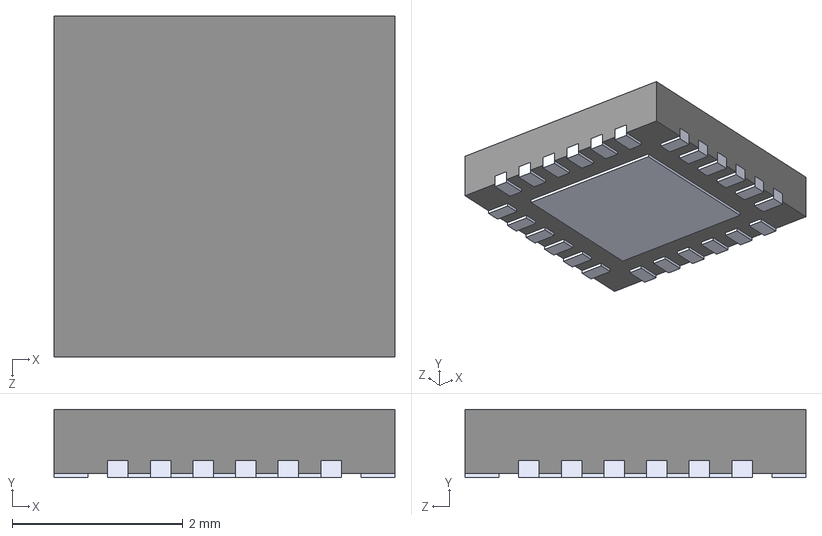
[picture p61: CAD file, 2025-11-08]
models/CP2102N-A02-GQFN24R.step
4.00 x 0.8 x 4.00 mm
