nrwiersma/hardware-components/models/USB_C_Receptacle_HRO_TYPE-C-31-M-12.step

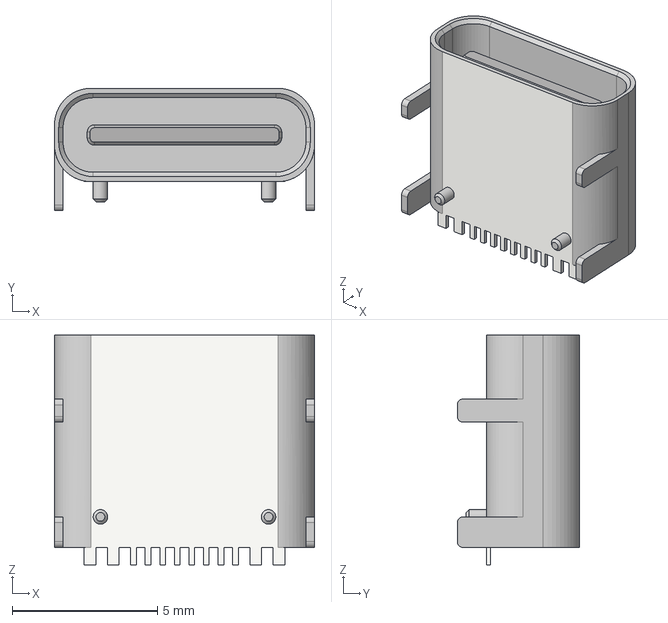
[picture p62: CAD file, 2025-11-08]
models/USB_C_Receptacle_HRO_TYPE-C-31-M-12.step
8.94 x 4.21 x 7.90 mm
