nrwiersma/hardware-components/models/ESP32-S3FN8.step

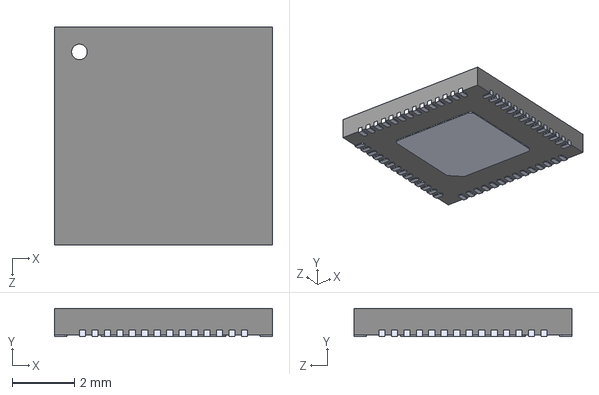
[picture p63: CAD file, 2025-11-08]
models/ESP32-S3FN8.step
7.00 x 0.9 x 7.00 mm
