nrwiersma/hardware-components/models/RFECA3216060A1T.step

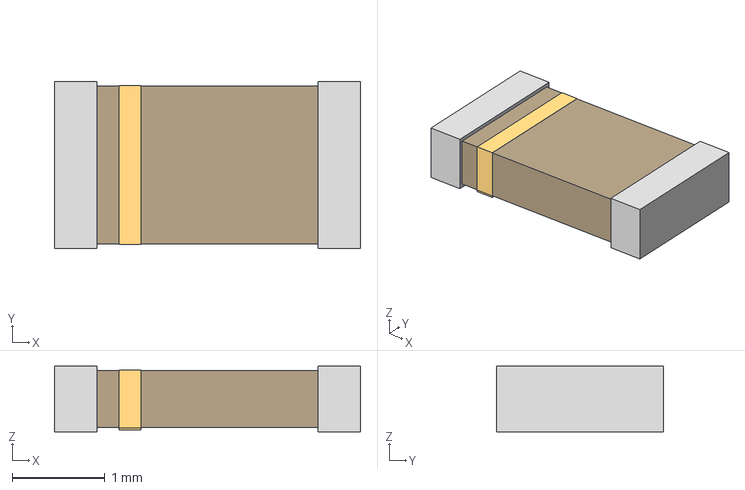
[picture p64: CAD file, 2025-11-08]
models/RFECA3216060A1T.step
3.30 x 1.80 x 0.711 mm
