nrwiersma/hardware-components/(list of files, cad)

Other CAD files:
models/L_0201_0603Metric.step
models/C_0805_2012Metric.step
models/L_0402_1005Metric.step
