nrwiersma/hardware-components/(commit log)

2025-11-08 feat: inital components
    [AG9900LP.step, CP2102N-A02-GQFN24R.step, DGUK111Q334AB2A2DP057.stp, ESP32-S3FN8.step, MB110S.STEP, RFECA3216060A1T.step, SMAJ58A.step, USB_C_Receptacle_HRO_TYPE-C-31-M-12.step]
2025-11-11 feat: add components for HomelabIO
    [MSOP8_MC_MCH.step, PUSB3F96X.STEP, UQFN-32-1.step]
2025-11-11 feat: add models
    [Bus_M.2_Socket_M.stp, MOLEX_104031-0811.stp, Molex_47659-1100.stp, TE_640455-4.step]
2025-11-12 fix: switch out out-of-stock components
2025-11-17 feat: add components
    [Bus_M.2_Socket_M.stp, LED_SK6812MINI.stp, Molex_47659-1100.stp, TE_640455-4.step]
2025-11-22 feat: update component list
    [LED_LTST-C295KGKRKT.STEP, Oscillator_ECS_400-10-37B2-CKM-TR.step, SW_KSC241JLFS.stp]
2025-12-01 feat: update models
    [PTS815SJM250SMTRLFS.stp, SW_KSC241JLFS.stp]
2025-12-20 feat: new componenets
    [SW_Panasonic_EVPAA.STEP]
2025-12-20 feat: move all models to be local
    [C_0201_0603Metric.step, C_0603_1608Metric.step, C_0805_2012Metric.step, Conn_JST_PH_S3B-PH-K_1x03_P2.00mm_Horizontal.step, Conn_JST_PH_S4B-PH-K_1x04_P2.00mm_Horizontal.step, Conn_PinHeader_2x02_P2.54mm_Vertical.step, Conn_PinHeader_2x04_P2.54mm_Vertical.step, Conn_PinHeader_2x05_P2.54mm_Vertical.step]
2025-12-20 feat: prefer step models
    [C_0402_1005Metric.step, L_Chilisin_BMRx00060630.step, R_0402_1005Metric.step, SW_Panasonic_EVPAA.STEP]
2026-08-22 feat: add new components
    [BH1750FVI-TR.step, Conn_PinSocket_2x04_P2.00mm_Vertical.step, Conn_PinSocket_2x04_P2mm_Vertical_SMD.step, D_SOD-323.step, HLK-LD2450.step, LED_WS2812C-2020.step, PowMan_TPS2116DRLR.step, Sensirion_DFN-4.step]
2026-09-28 feat: new components
    [C_Pol_Elec_8x10.step, Conn_BarrelJack_KHE_DC-044A-20A.step, Conn_RCA_SameSky_RCJ-041.step, Conn_Weidmuller_8000078321.step, HTSSOP-28.step, L_Sunltech_SLD10D40S100MTT.step, PowMan_TPS2121RUXR.step, SOIC-8_5.3x5.3mm_P1.27mm.step]
