nrwiersma/hardware-components/(notices)

Notices in the files:
models/LED_0603_1608Metric.step:
Copyright (C) 2018, kicad StepUp
This work is licensed under the [Creative Commons CC-BY-SA 4.0 License](https://creativecommons.org/licenses/by-sa/4.0/legalcode),
with the following exception:
To the extent that the creation of electronic designs that use 'Licensed Material' can be considered to be 'Adapted Material',
You are free to use the library data in your own projects without the obligation to share your project files under this or any other license agreement.
models/TPD4EUSB30_USON-10.step:
Copyright (C) 2017, kicad StepUp
This program is free software: you can redistribute it and/or modify
it under the terms of the GNU General Public License as published by
the Free Software Foundation, either version 3 of the License, or
any later version.
itself might be covered by the GNU General Public License.
models/Fuse_1206_3216Metric.step:
Copyright (C) 2020, kicad StepUp
models/UQFN-32-1.step:
Copyright (C) 2025, KiCAD
This work is licensed under the
[Creative Commons CC-BY-SA 4.0 License](https://creativecommons.org/licenses/by-sa/4.0/legalcode),
project files under this or any other license agreement. However, if you wish to distribute
models/SOT-89-3.step:
Copyright (C) 2023, Ray Benitez
models/Conn_JST_PH_S4B-PH-K_1x04_P2.00mm_Horizontal.step:
Copyright (C) 2017, Rene Poeschl
